JavaJimbo/DC950InterfaceBoxPCB/README.md

# DC950InterfaceBoxPCB
Interface box released for production in December 2017
