JavaJimbo/DC950InterfaceBoxPCB/PCB DC950 Test System/DC950 DigiKey Order V1.0.xlsx

# | Quantity | Part Number | Manufacturer Part Number | Description | Customer Reference | Backorder | Unit Price | Extended Price
1 | 3 | 1568-1540-ND | DEV-09713 | USB 32-BIT WHACKER - PIC32MX795 |  | 0 | 39.95 | 119.85
2 | 6 | 1003-1947-ND | 980-2000-350 | BACKSHELL DB9 METALIZED PLASTIC |  | 0 | 5.1 | 30.60
3 | 10 | AE10972-ND | A-DS 09 LL/Z | CONN DSUB PLUG 9POS STR SLDR CUP |  | 0 | 0.485 | 4.85
4 | 10 | AE11063-ND | A-DF 09 LL/Z | CONN DSUB RCPT 9POS STR SLDR CUP |  | 0 | 0.509 | 5.09
5 | 1 | T1346-5-ND | 30-00507 | CABLE 6COND 24AWG BLK 5M |  | 0 | 13.03 | 13.03
6 | 3 | 811-2196-5-ND | OKI-78SR-5/1.5-W36-C | CONV DC/DC 7.5W 36VIN 5VOUT |  | 0 | 4.3 | 12.90
7 | 6 | 501-1316-ND | 6883 | DUAL BINDING POSTS |  | 0 | 2.77 | 16.62
8 | 2 | HM1123-ND | 1455Q1602 | BOX ALUM NATURAL 6.3"LX4.92"W |  | 0 | 21.59 | 43.18
9 | 10 | AE9991-ND | A 14-LC-TR | CONN IC DIP SOCKET 14POS TIN |  | 0 | 0.269 | 2.69
10 | 3 | AE10924-ND | A-DF 09 A/KG-T4S | CONN D-SUB RCPT 9POS R/A SOLDER |  | 0 | 0.79 | 2.37
11 | 6 | 501-1072-ND | MDP-2 | PLUG BANA DBL WIRE GUIDE RED |  | 0 | 3.34 | 20.04
12 | 6 | 1568-1209-ND | BOB-12009 | LOGIC LEVEL CONVERTER - BI-DIREC |  | 0 | 2.95 | 17.70
13 | 3 | 497-2344-5-ND | ULN2003A | IC PWR RELAY 7NPN 1:1 16DIP |  | 0 | 0.56 | 1.68
14 | 10 | Z108-ND | G5V-2-H1 DC5 | RELAY GENERAL PURPOSE DPDT 1A 5V |  | 0 | 2.983 | 29.83
15 | 3 | A31422-ND | 5555165-1 | CONN MOD JACK 6P6C R/A UNSHLD |  | 0 | 0.93 | 2.79
16 | 3 | 486-3380-ND | 4840.22 | CONN PWR JACK 2.1X5.5MM SOLDER |  | 0 | 1.81 | 5.43
17 | 10 | 36-739-ND | 739 | GROMMET 0.250" RUBBER BLACK |  | 0 | 0.209 | 2.09
18 | 3 | 296-1402-5-ND | MAX232N | IC DUAL EIA-232 DRVR/RCVR 16-DIP |  | 0 | 1.13 | 3.39
19 | 3 | 5300-25-RC-ND | 5300-25-RC | FIXED IND 100UH 550MA 670 MOHM |  | 0 | 0.99 | 2.97
20 | 1 | 296-1391-5-ND | LM324N | IC OPAMP GP 1.2MHZ 14DIP |  | 0 | 0.52 | 0.52
21 | 25 | WM2000-ND | 22-01-3027 | CONN HOUS 2POS .100 W/RAMP/RIB |  | 0 | 0.0892 | 2.23
22 | 3 | WM2005-ND | 0022013077 | CONN HOUS 7POS .100 W/RAMP/RIB |  | 0 | 0.33 | 0.99
23 | 3 | 478-2491-1-ND | VA100018A400DL | VARISTOR 25.5V 40A AXIAL |  | 0 | 0.66 | 1.98
24 | 5 | 507-1291-ND | 5TT 1-R | FUSE GLASS 1A 250VAC 5X20MM |  | 0 | 0.282 | 1.41
25 | 3 | WK6245-ND | 65600001009 | FUSE BLOK CARTRIDGE 250V 10A PCB |  | 0 | 0.91 | 2.73
26 | 20 | 493-14724-1-ND | ULD1H010MDD1TD | CAP ALUM 1UF 20% 50V THRU HOLE |  | 0 | 0.185 | 3.70
27 | 20 | 1189-1883-ND | 50YXM10MEFC5X11 | CAP ALUM 10UF 20% 50V RADIAL |  | 0 | 0.184 | 3.68
28 | 2 | 432-1153-ND | 2M1-SP1-T6-B1-M1QE | SWITCH TOGGLE SPDT 5A 125V |  | 0 | 3.56 | 7.12
