JavaJimbo/DC950InterfaceBoxPCB/PCB DC950 Test System/DC950TestSystem OnePage.pdf

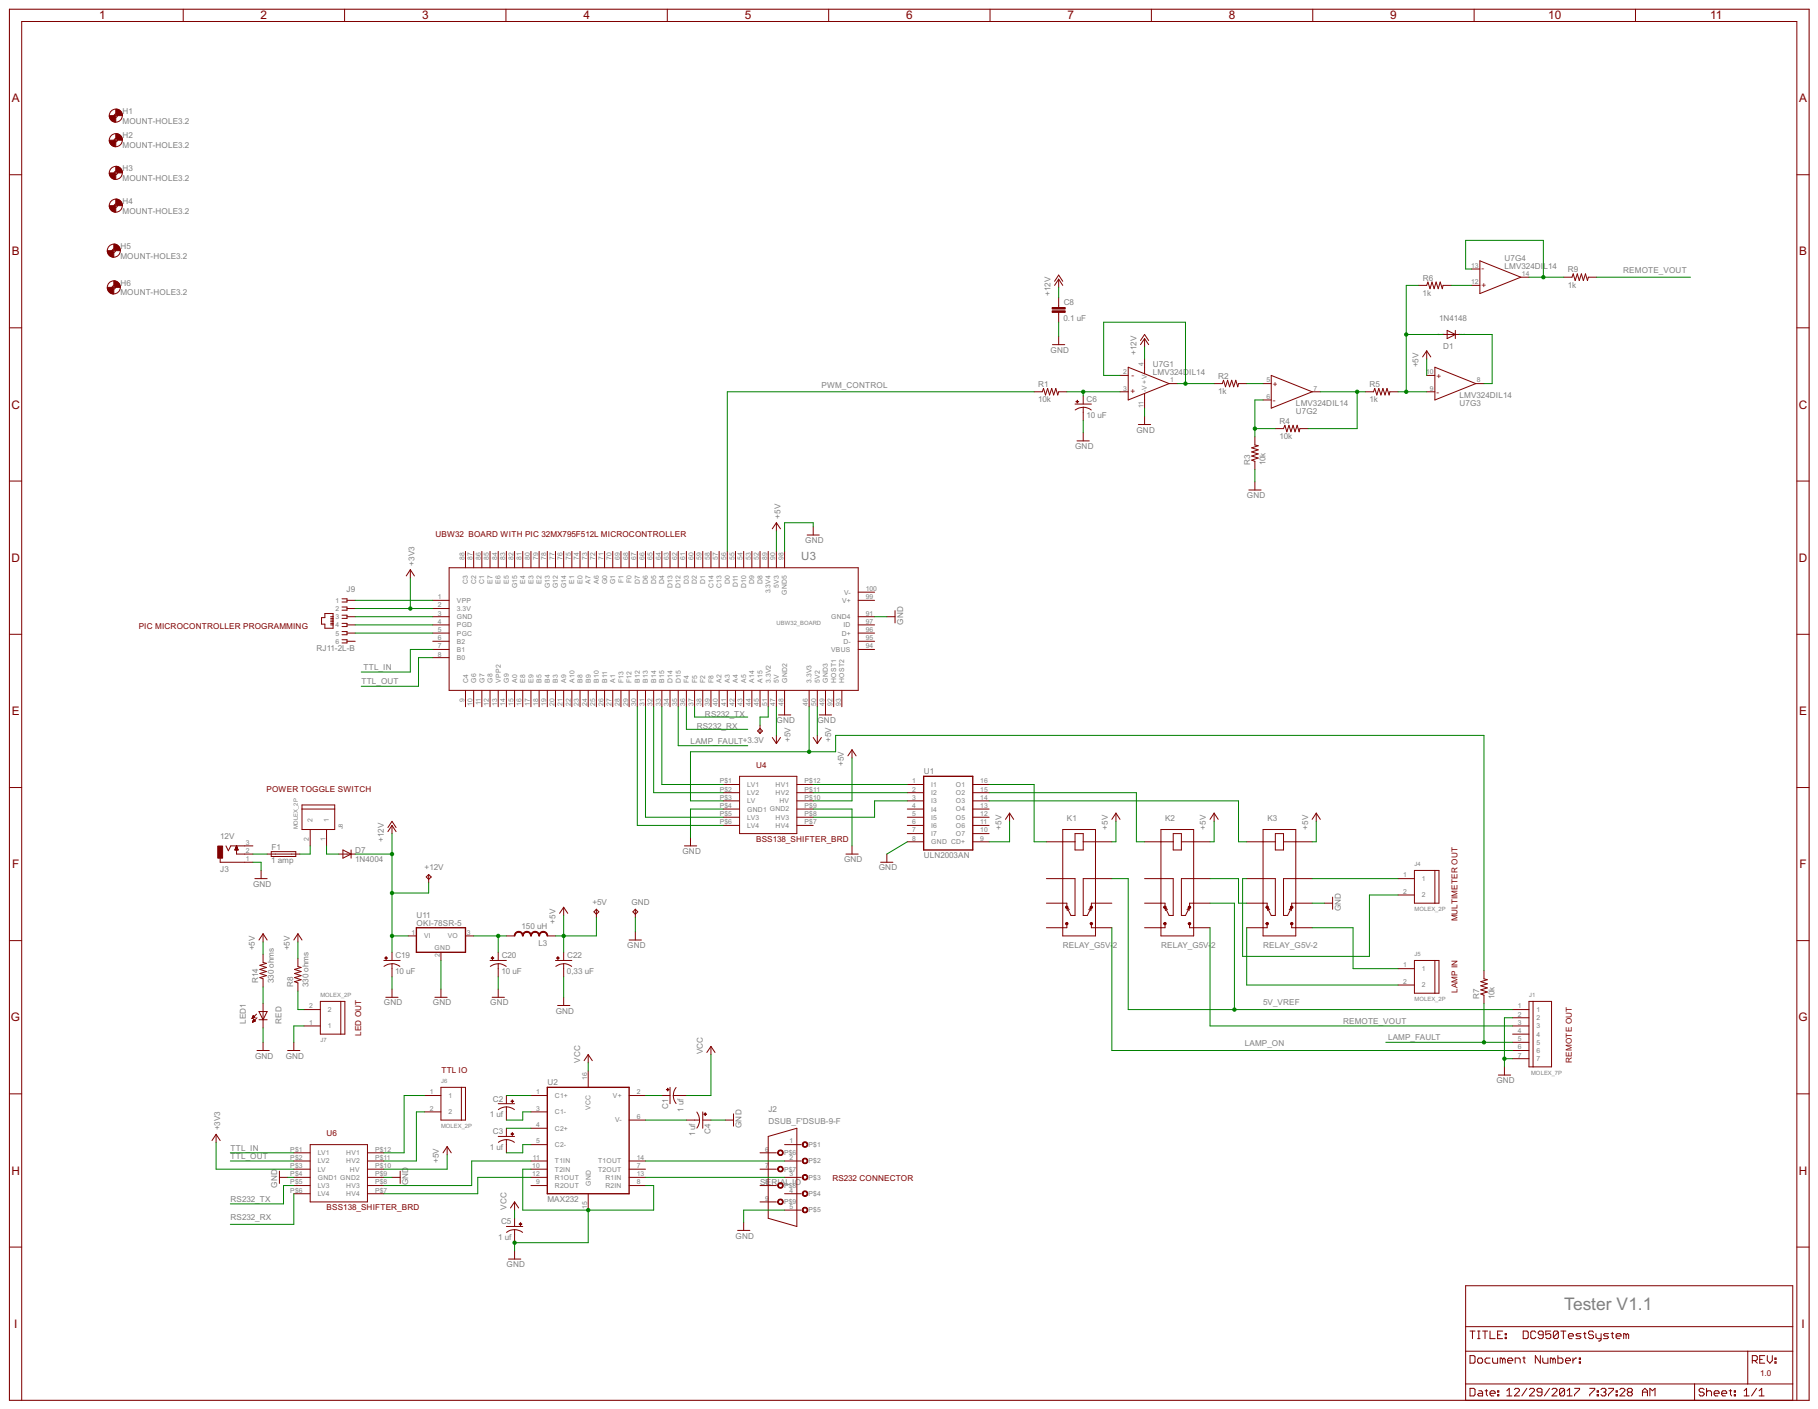
[picture p1: page 1]

MOUNT-HOLE3.2 MOUNT-HOLE3.2

UBW32 BOARD WITH PIC 32MX795F512L MICROCONTROLLER

MULTIMETER OUT LAMP IN
