JavaJimbo/DC950InterfaceBoxPCB/PCB DC950 Test System/DC950TestSystem.pdf

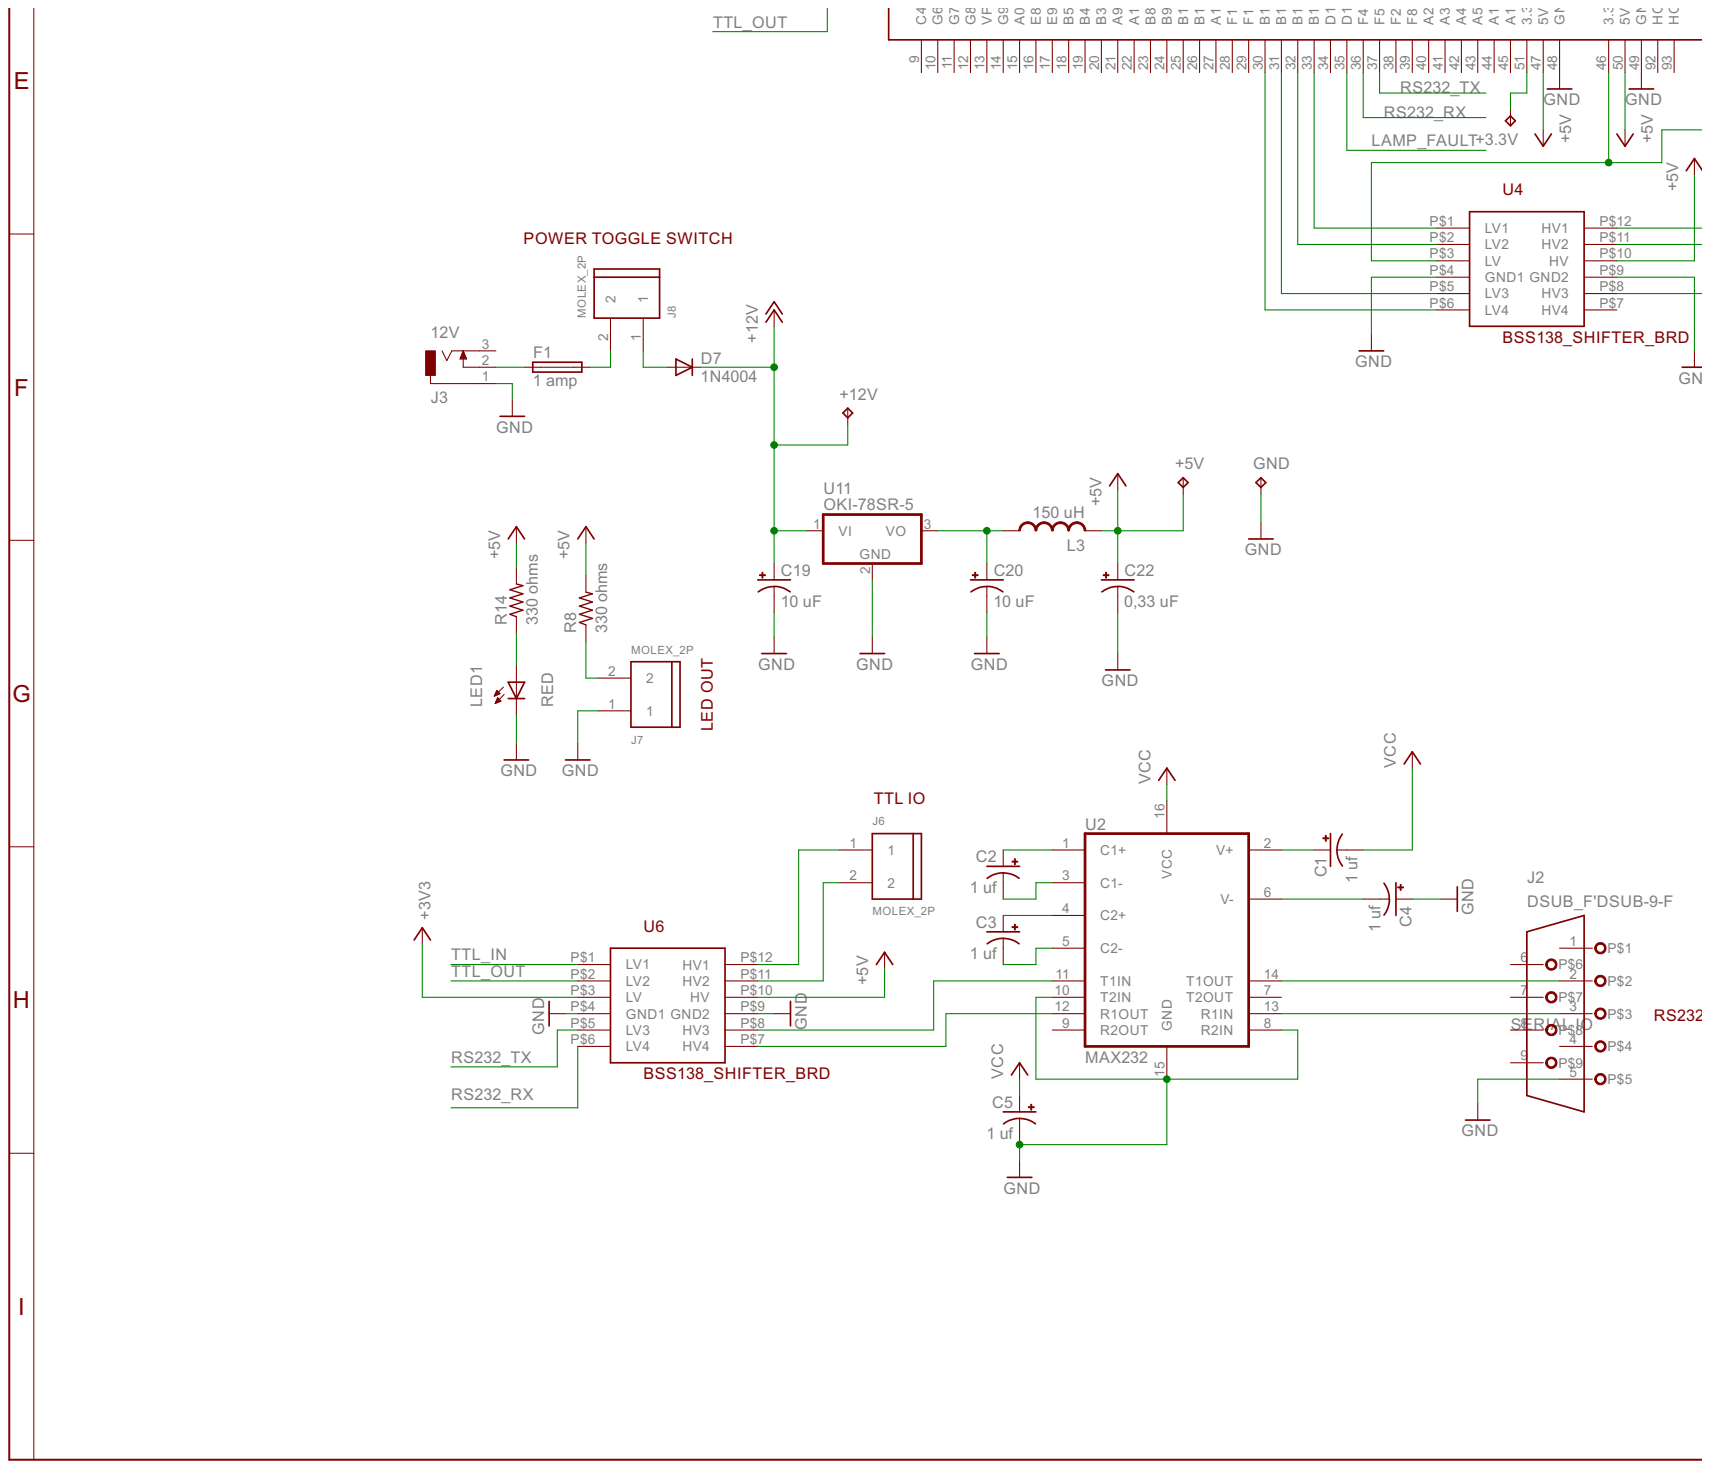
[picture p2: page 1]

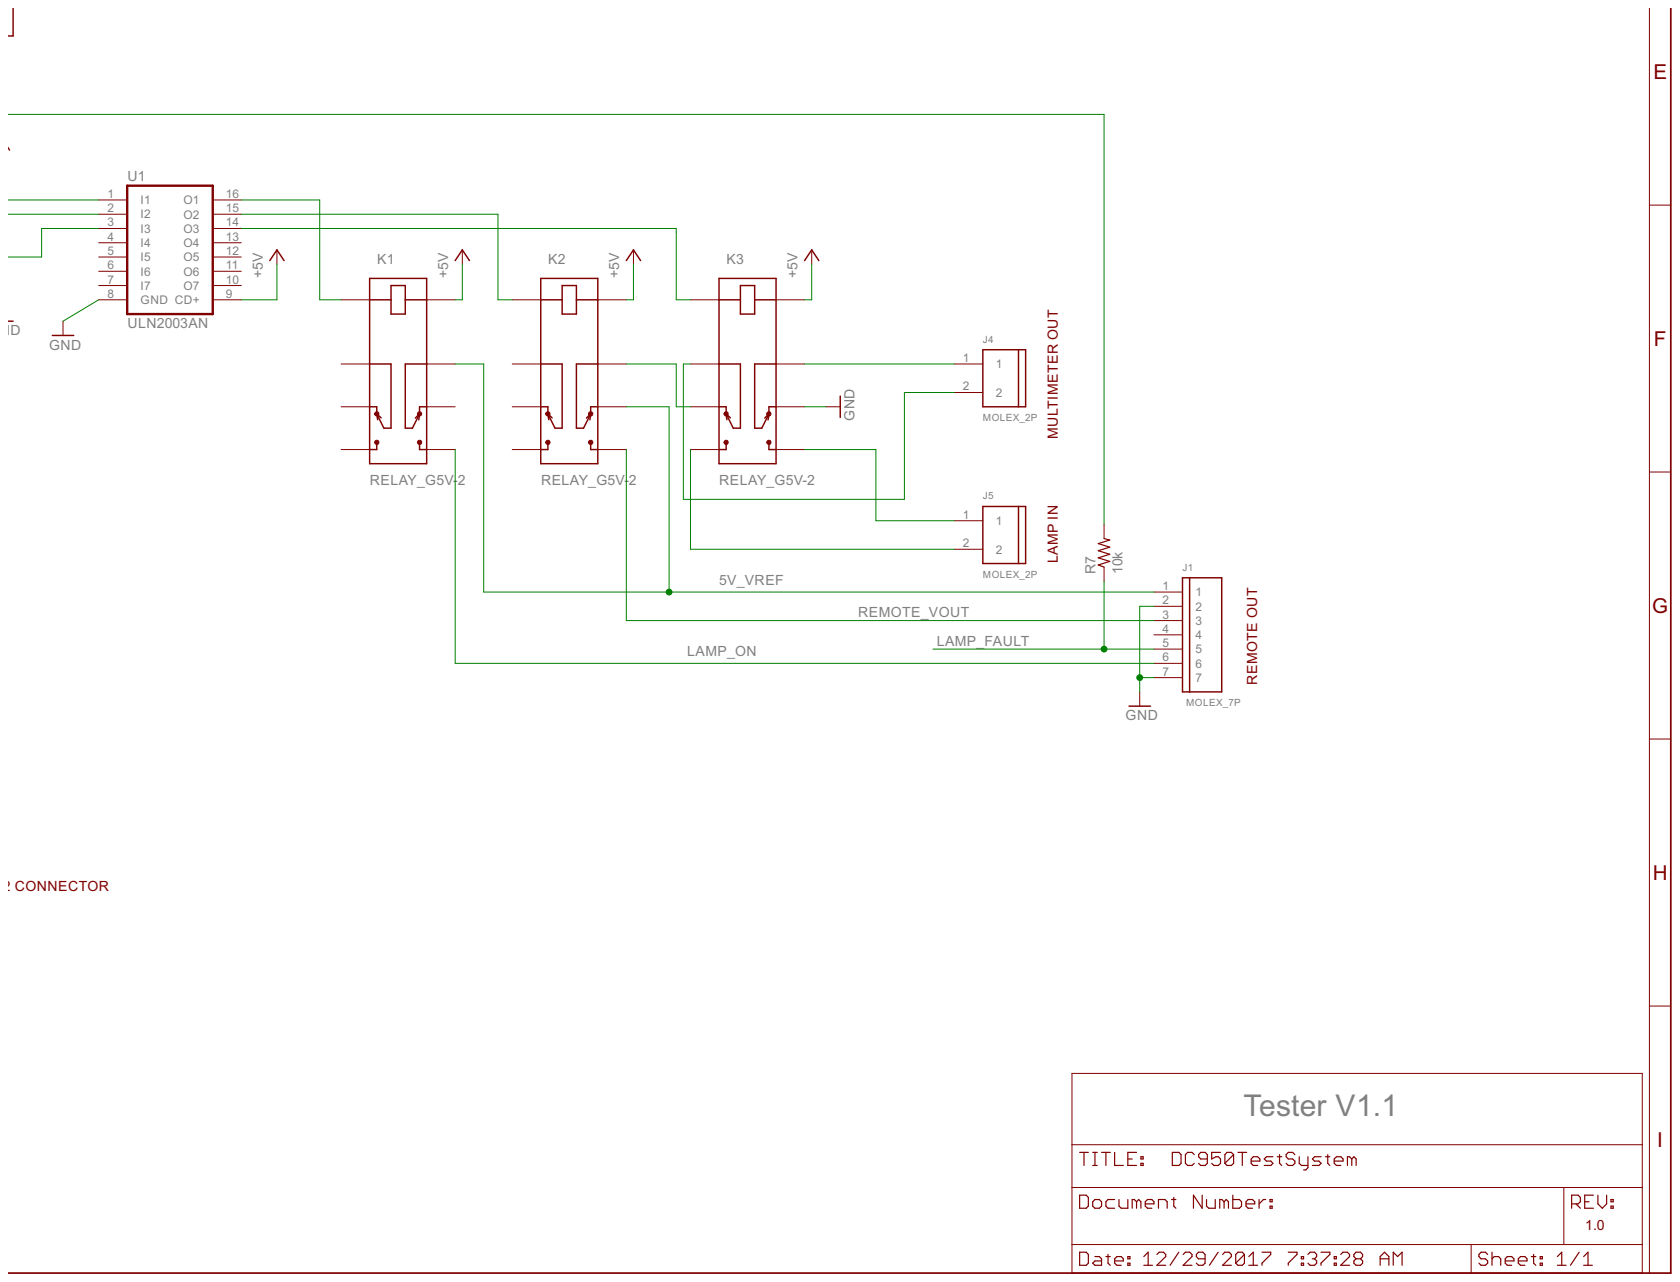
[picture p3: page 2]

MULTIMETER OUT LAMP IN

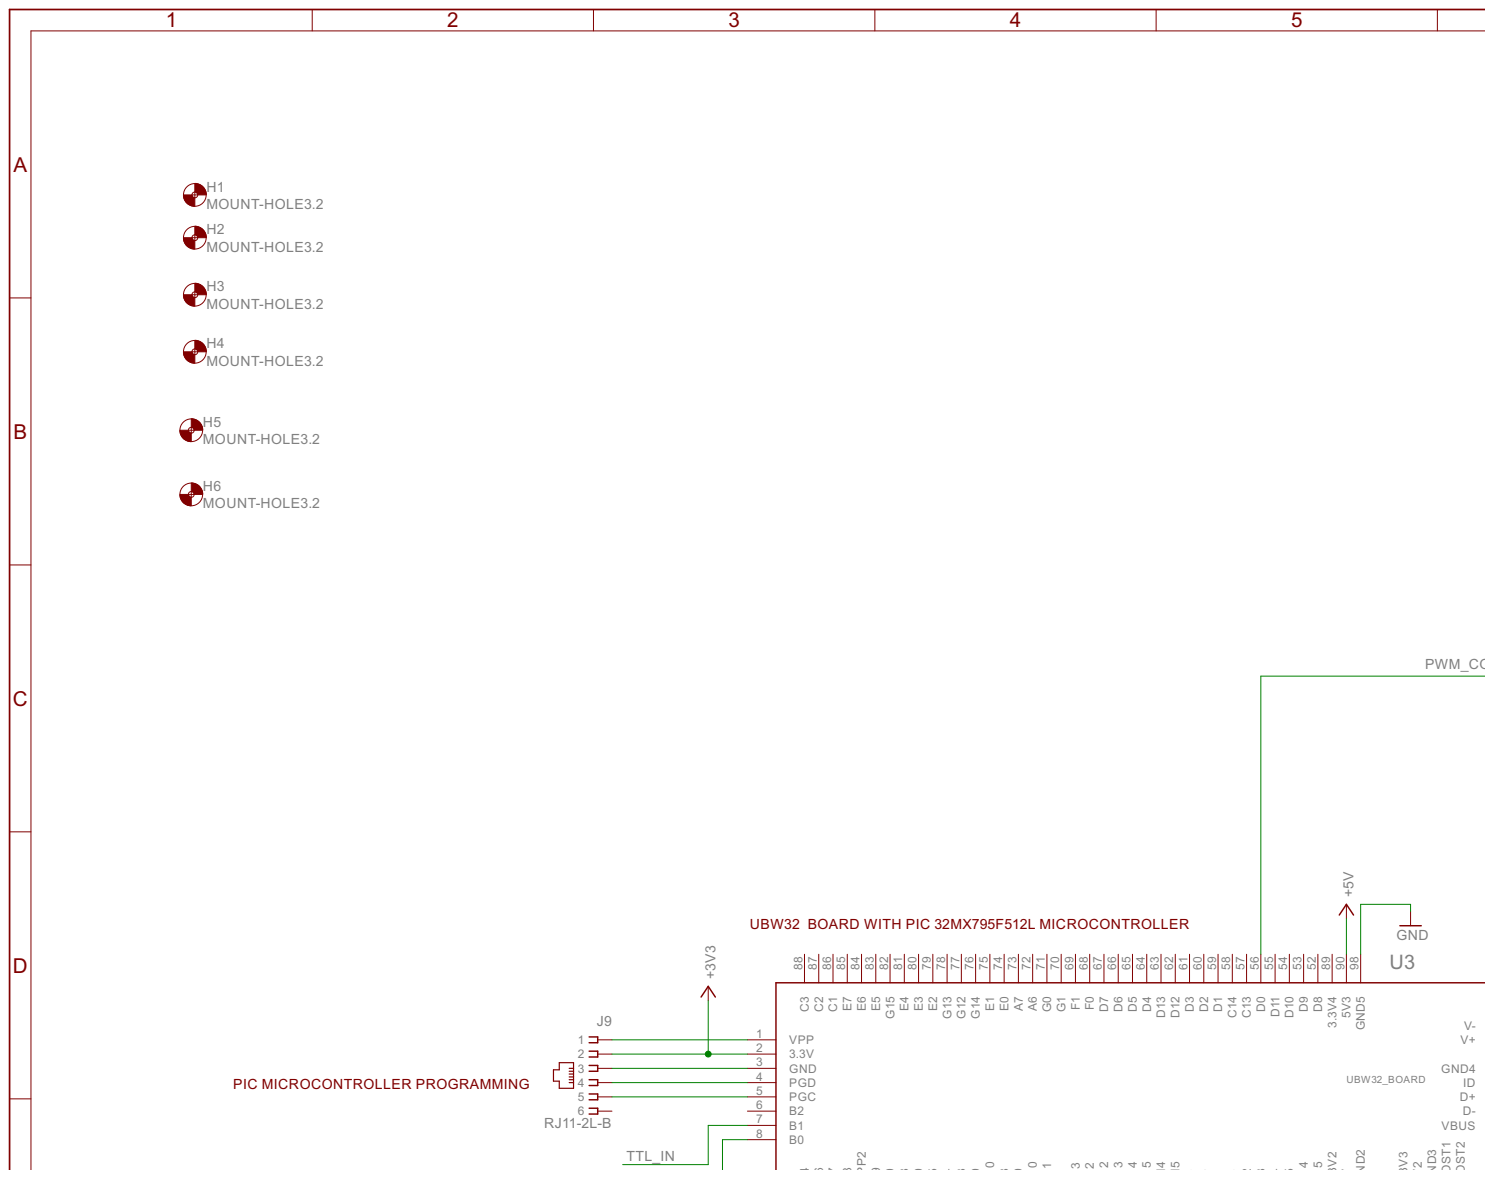
[picture p4: page 3]

UBW32 BOARD WITH PIC 32MX795F512L MICROCONTROLLER

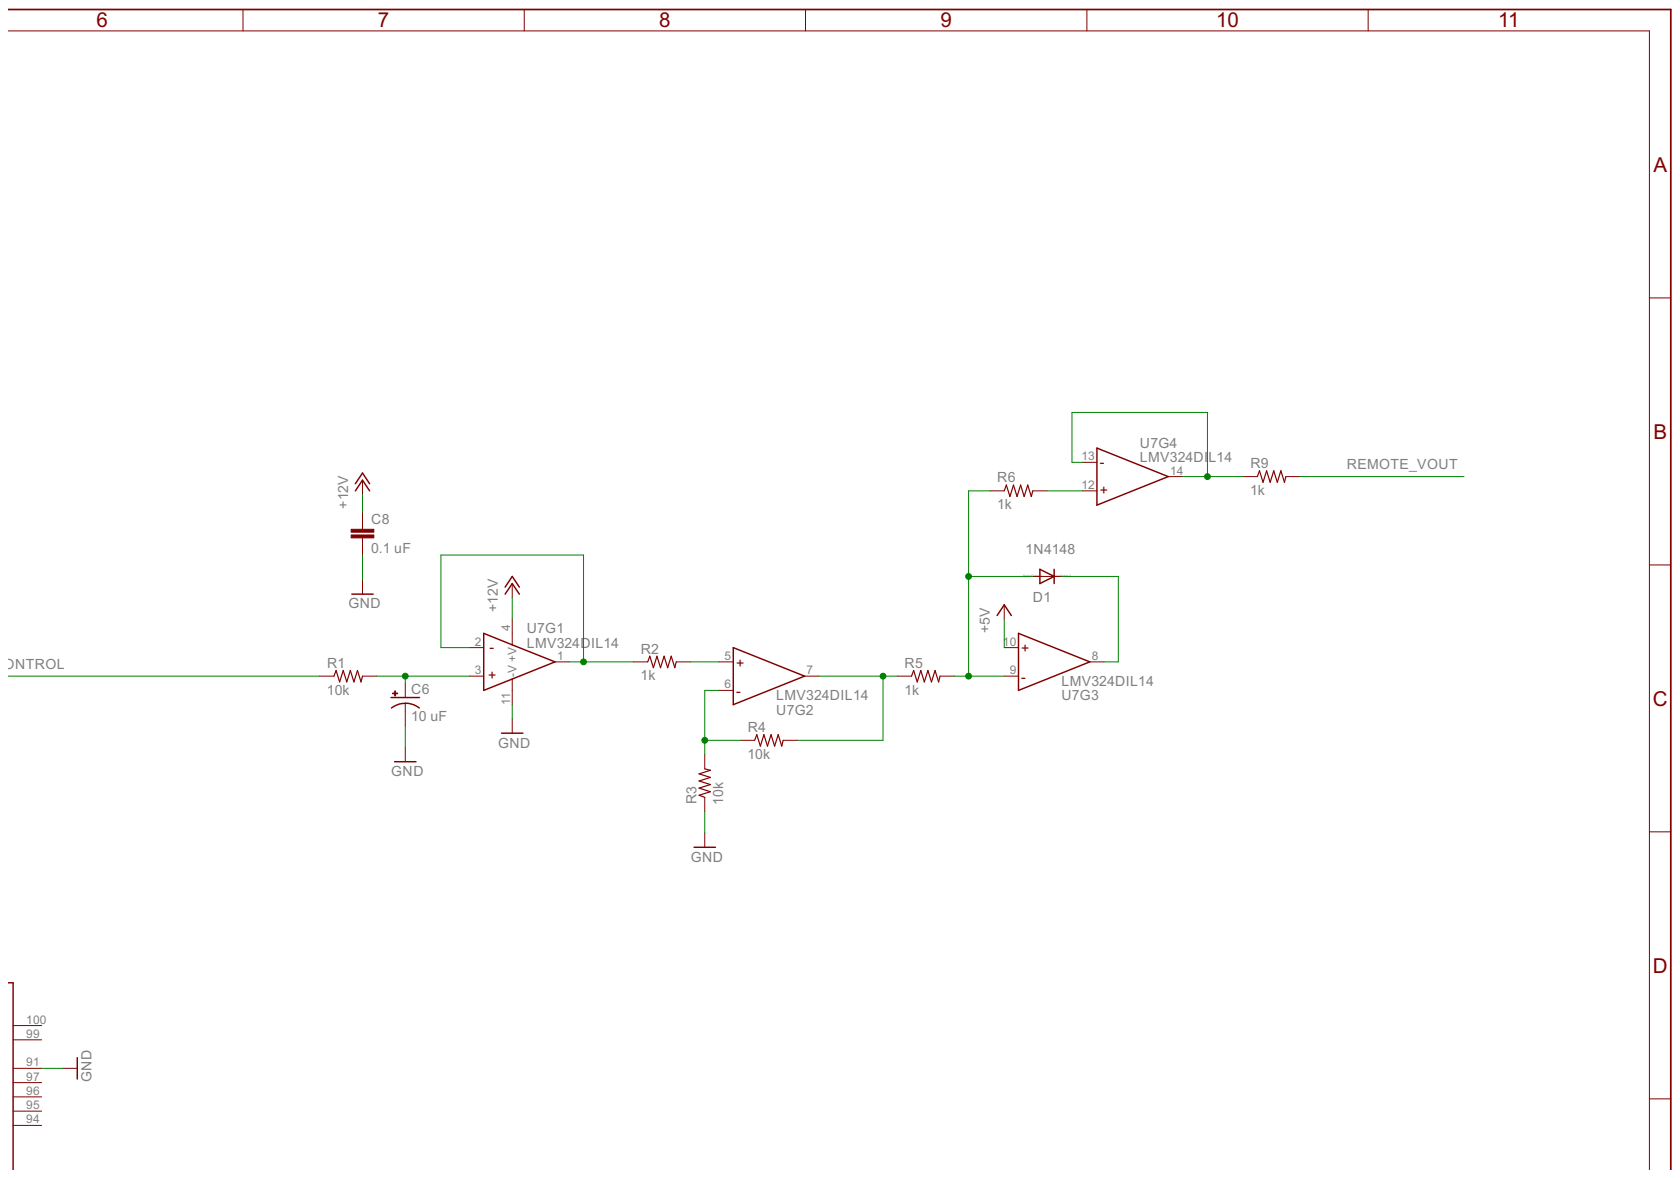
[picture p5: page 4]
