JavaJimbo/DC950InterfaceBoxPCB/PCB DC950 Test System/DC950TestSystem.brd

## EAGLE design PCB DC950 Test System/DC950TestSystem.brd (2017-12-29)

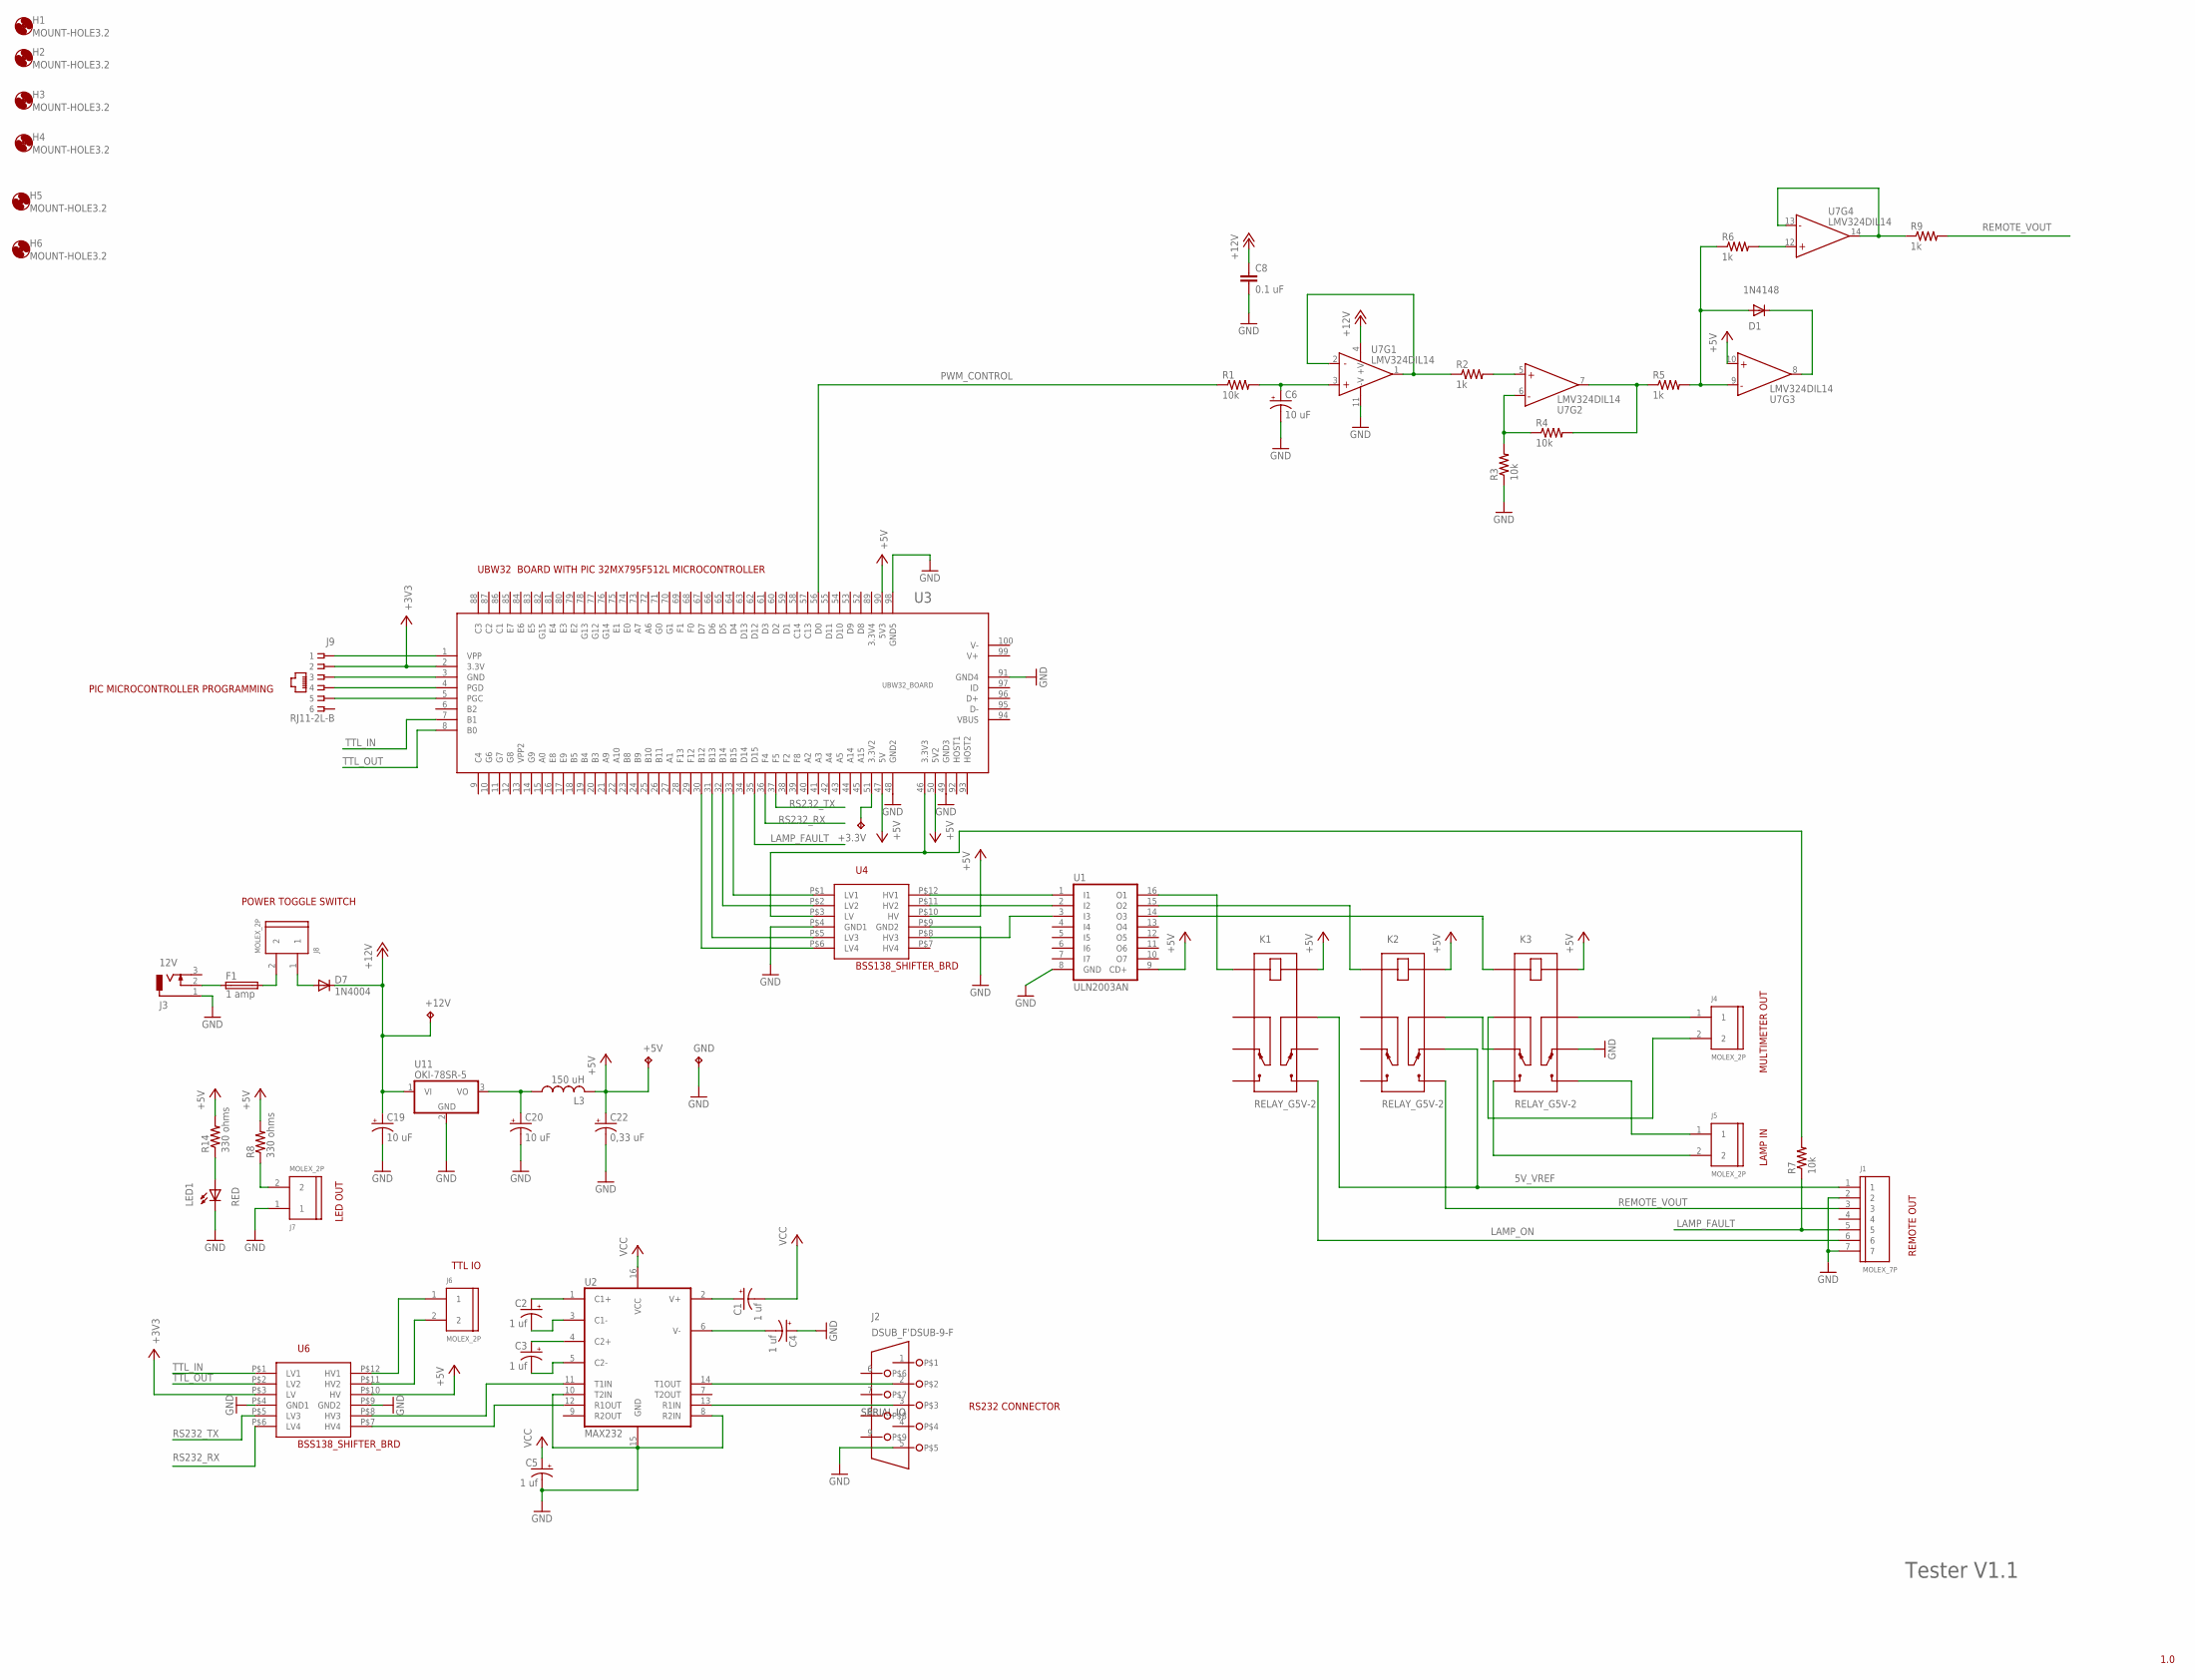
[picture p6: schematic DC950TestSystem.sch]

Parts:
+3.3V, +5V, +12V: TP; TESTPAD
C1, C2, C3, C4, C5: 1 uf; E2-5
C6, C19, C20: 10 uF; E2-5
C8: 0.1 uF; C5B2.5
C22: 0,33 uF; E2-5
D1: 1N4148; DO35-10
D7: 1N4004; DO41-10
F1: 1 amp; SH22,5
GND: TP; TESTPAD
H1, H2, H3, H4, H5, H6: MOUNT-HOLE3.2; 3,2
J1: MOLEX_7P
J2: DSUB_F'DSUB-9-F; H5M09RA
J3: 12V; DCJ0303
J4, J5, J6, J7, J8: MOLEX_2P
J9: RJ11-2L-B; RJ11-NO_SHIELD
K1, K2, K3: RELAY_G5V-2
L3: 150 uH; 0204/7
LED1: RED; LED5MM
R1, R3, R4, R7: 10k; 1/4_WATT
R2, R5, R6, R9: 1k; 1/4_WATT
R8, R14: 330 ohms; 0207/10
U1: ULN2003AN; DIL16
U2: MAX232; DIL16
U3: UBW32_BOARD; UBW32
U4, U6: BSS138_SHIFTER_BRD
U7: LMV324DIL14; DIL14
U11: OKI-78SR-5; TO220V

Connections:
3.3V4: U3.89 (3.3V4)
5V_VREF: J1.1, K1.13, K2.11
+3V3: J9.2, U3.2 (3.3V), U6.P$3 (LV)
+5V: +5V.P$1, C22.+, K1.16, K2.16, K3.16, L3.2, R8.2, R14.2, U1.9 (CD+), U3.47 (5V), U3.50 (5V2), U3.90 (5V3), U4.P$10 (HV), U6.P$10 (HV), U7.10 (+IN)
+12V: +12V.P$1, C8.1, C19.+, D7.C, U7.4 (+V), U11.1 (VI)
GND: C4.+, C5.-, C6.-, C8.2, C19.-, C20.-, C22.-, GND.P$1, J1.2, J1.7, J2.5, J3.1, J7.1, K3.11, LED1.K (C), R3.1, U1.8 (GND), U2.8 (R2IN), U2.10 (T2IN), U2.15 (GND), U3.48 (GND2), U3.49 (GND3), U3.91 (GND4), U3.98 (GND5), U4.P$4 (GND1), U4.P$9 (GND2), U6.P$4 (GND1), U6.P$9 (GND2), U7.11 (-V), U11.2 (GND)
LAMP_FAULT: J1.5, R7.1, U3.35 (D15)
LAMP_ON: J1.6, K1.9
unnamed: F1.1, J3.2
unnamed: J9.3, U3.3 (GND)
unnamed: F1.2, J8.2
unnamed: U2.12 (R1OUT), U6.P$7 (HV4)
unnamed: U2.11 (T1IN), U6.P$8 (HV3)
unnamed: J9.1, U3.1 (VPP)
unnamed: J6.1, U6.P$12 (HV1)
unnamed: J9.4, U3.4 (PGD)
unnamed: J9.5, U3.5 (PGC)
unnamed: R2.1, U7.1 (OUT), U7.2 (-IN)
unnamed: C6.+, R1.2, U7.3 (+IN)
unnamed: R3.2, R4.1, U7.6 (-IN)
unnamed: R4.2, R5.1, U7.7 (OUT)
unnamed: J6.2, U6.P$11 (HV2)
unnamed: R2.2, U7.5 (+IN)
unnamed: D1.A, R5.2, R6.1, U7.9 (-IN)
unnamed: D1.C, U7.8 (OUT)
unnamed: LED1.A, R14.1
unnamed: J2.2, U2.14 (T1OUT)
unnamed: J2.3, U2.13 (R1IN)
unnamed: R6.2, U7.12 (+IN)
unnamed: R7.2, U3.46 (3.3V3), U4.P$3 (LV)
unnamed: C2.+, U2.1 (C1+)
unnamed: C2.-, U2.3 (C1-)
unnamed: C3.+, U2.4 (C2+)
unnamed: C3.-, U2.5 (C2-)
unnamed: C1.+, U2.2 (V+)
unnamed: C4.-, U2.6 (V-)
unnamed: U3.33 (B15), U4.P$1 (LV1)
unnamed: U3.32 (B14), U4.P$2 (LV2)
unnamed: U3.31 (B13), U4.P$5 (LV3)
unnamed: U3.30 (B12), U4.P$6 (LV4)
unnamed: +3.3V.P$1, U3.51 (3.3V2)
unnamed: U1.1 (I1), U4.P$12 (HV1)
unnamed: U1.2 (I2), U4.P$11 (HV2)
unnamed: U1.3 (I3), U4.P$8 (HV3)
unnamed: J7.2, R8.1
unnamed: K1.1, U1.16 (O1)
unnamed: K2.1, U1.15 (O2)
unnamed: K3.1, U1.14 (O3)
unnamed: D7.A, J8.1
unnamed: C20.+, L3.1, U11.3 (VO)
unnamed: J4.1, K3.13
unnamed: J4.2, K3.4
unnamed: J5.1, K3.9
unnamed: J5.2, K3.8
unnamed: K2.13, K3.6
unnamed: R9.1, U7.13 (-IN), U7.14 (OUT)
PWM_CONTROL: R1.1, U3.56 (D0)
REMOTE_VOUT: J1.3, K2.9, R9.2
RS232_RX: U3.36 (F4), U6.P$6 (LV4)
RS232_TX: U3.37 (F5), U6.P$5 (LV3)
TTL_IN: U3.7 (B1), U6.P$1 (LV1)
TTL_OUT: U3.8 (B0), U6.P$2 (LV2)
V+: U3.99 (V+)
V-: U3.100 (V-)
VBUS: U3.94 (VBUS)
VCC: C1.-, C5.+, U2.16 (VCC)

Notes on the sheet:
SERIAL IO
1.0
Tester V1.1
MULTIMETER OUT
LAMP IN
REMOTE OUT
LED OUT
TTL IO
POWER TOGGLE SWITCH
RS232 CONNECTOR
PIC MICROCONTROLLER PROGRAMMING
UBW32 BOARD WITH PIC 32MX795F512L MICROCONTROLLER

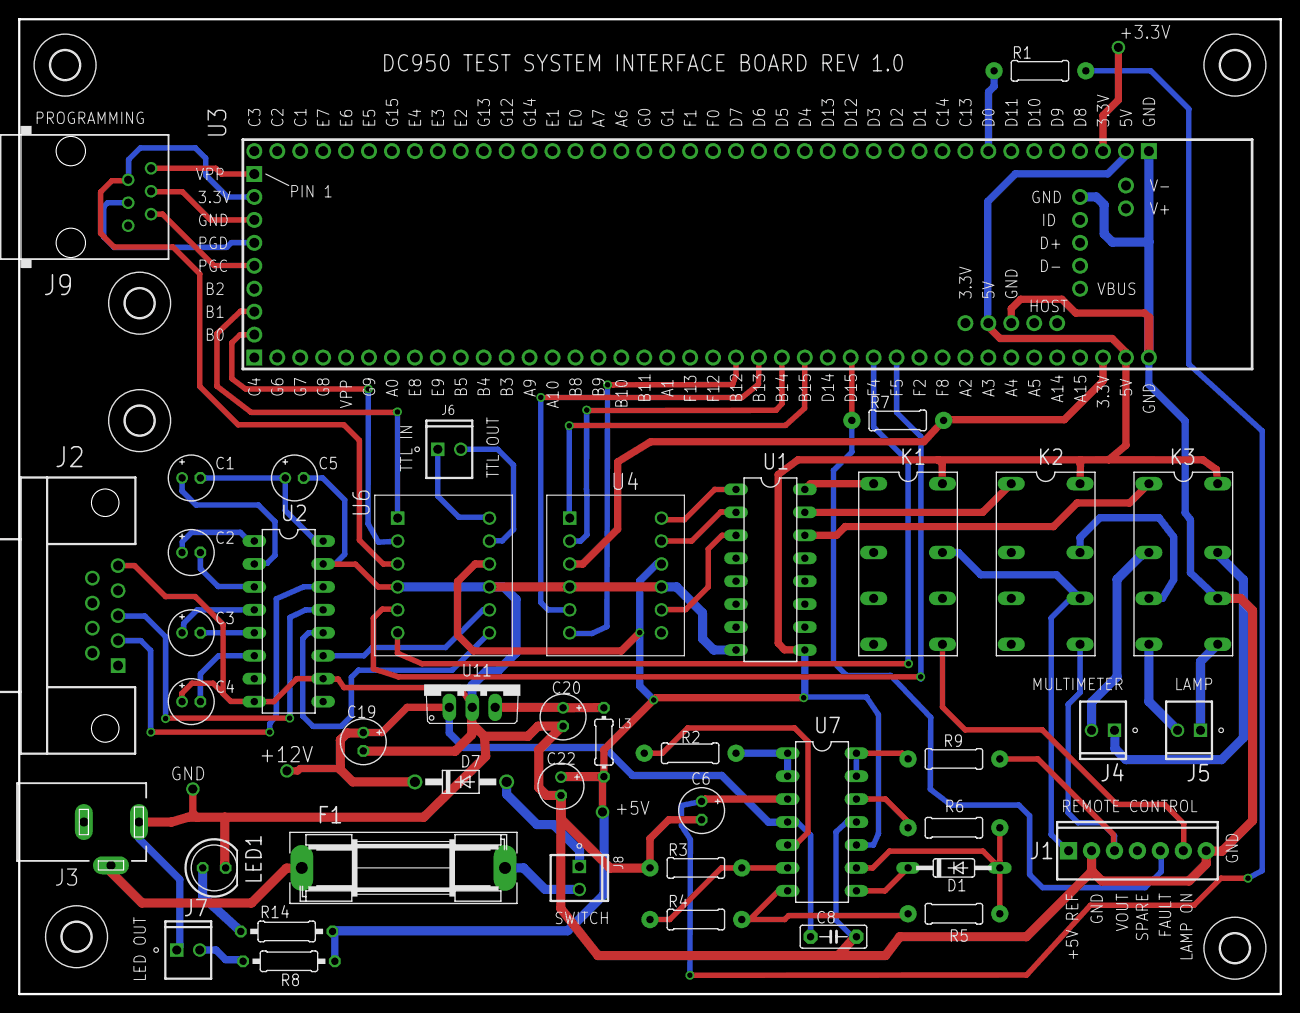
[picture p7: board DC950TestSystem.brd from above]

Board: 2 copper layers, 139.7 x 108.0 mm, 54 parts (0 on the bottom side), 62 nets.
